philippe86220/Enregistreur-GPS-GPX-LOLIN-S2-Mini/images/Lolin_S2_mini-2.png

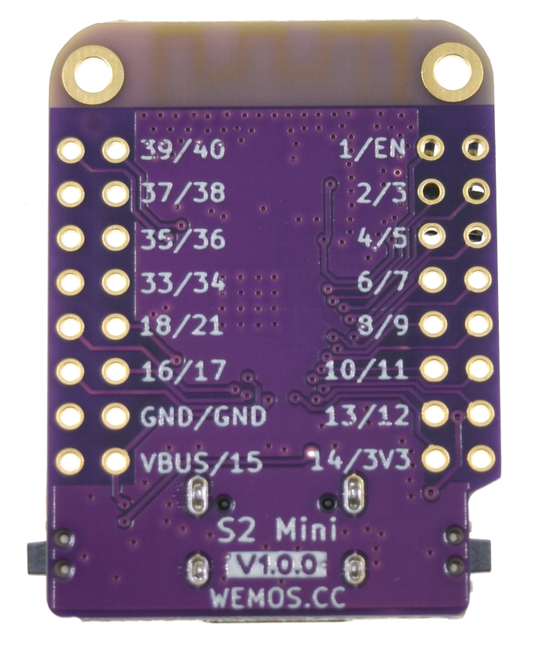
images/Lolin_S2_mini-2.png
