philippe86220/Enregistreur-GPS-GPX-LOLIN-S2-Mini/(commit log)

2026-11-10 Add README for GPS logger project
    Added detailed documentation for GPS logger project including features, hardware, wiring, libraries, usage instructions, and function references.
2026-11-10 Include schematic section in README
    Add schematic image reference to README.
2026-11-10 Update schematic image format in README
2026-11-10 Update schematic image path in README.md
2026-11-10 Update schematic image format from SVG to PNG
2026-11-12 Update README with details on data loss prevention
    Clarified the method of adding points and potential data loss during power interruptions.
2026-11-12 Update README with PCB fabrication information
    Added PCB fabrication details and updated section titles.
2026-11-13 Fix track file naming in README
2026-11-13 Specify OS requirements for downloading trace
