philippe86220/Enregistreur-GPS-GPX-LOLIN-S2-Mini/images/GPS3.JPG

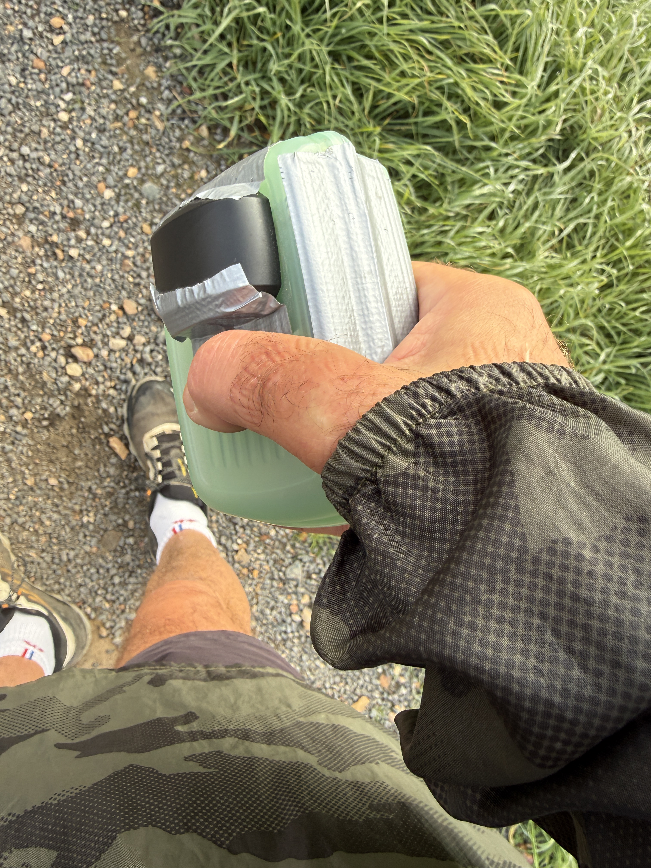
[picture p3: images/GPS3.JPG]
images/GPS3.JPG
